Maslinolov/Wideband_Oxygen_Sensor/Readme.txt

В качестве инидкатора используется проект Nixie_Thermometer
