Maslinolov/Wideband_Oxygen_Sensor/Australian DIY Wide Band Information_files/riro.gif

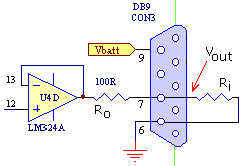
Australian DIY Wide Band Information_files/riro.gif
