Maslinolov/Wideband_Oxygen_Sensor/Australian DIY Wide Band Information_files/voutoff.gif

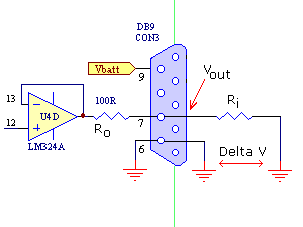
Australian DIY Wide Band Information_files/voutoff.gif
