Maslinolov/Wideband_Oxygen_Sensor/Australian DIY Wide Band Information_files/wblambda.gif

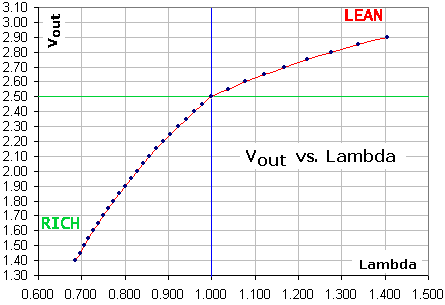
Australian DIY Wide Band Information_files/wblambda.gif
