Maslinolov/Wideband_Oxygen_Sensor/diy-wb_a.gif

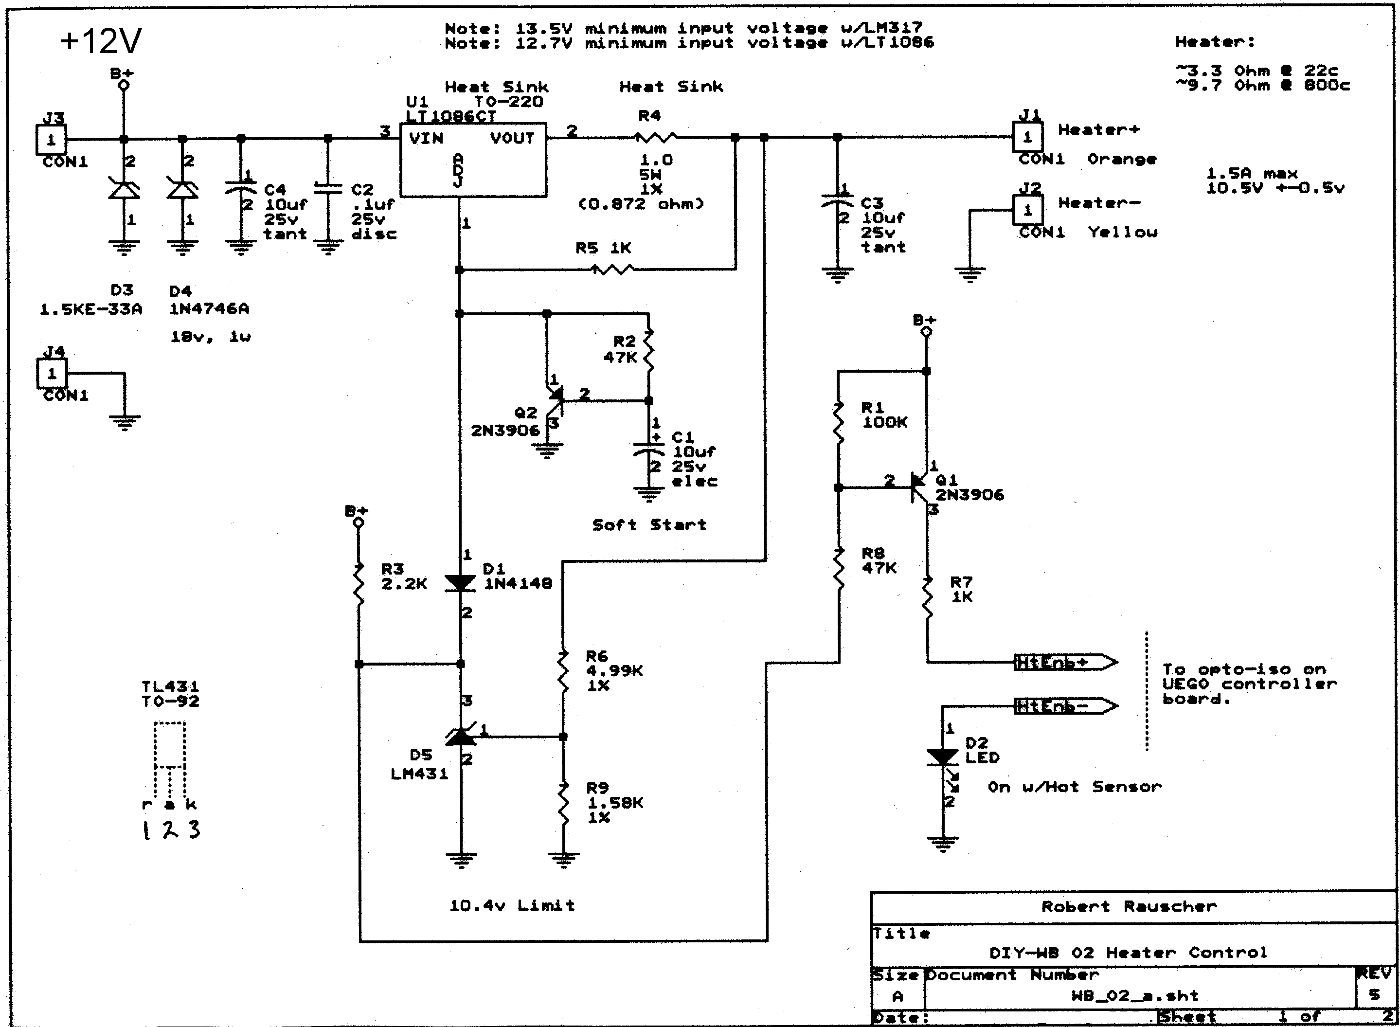
diy-wb_a.gif
