Maslinolov/Wideband_Oxygen_Sensor/diywb_b.gif

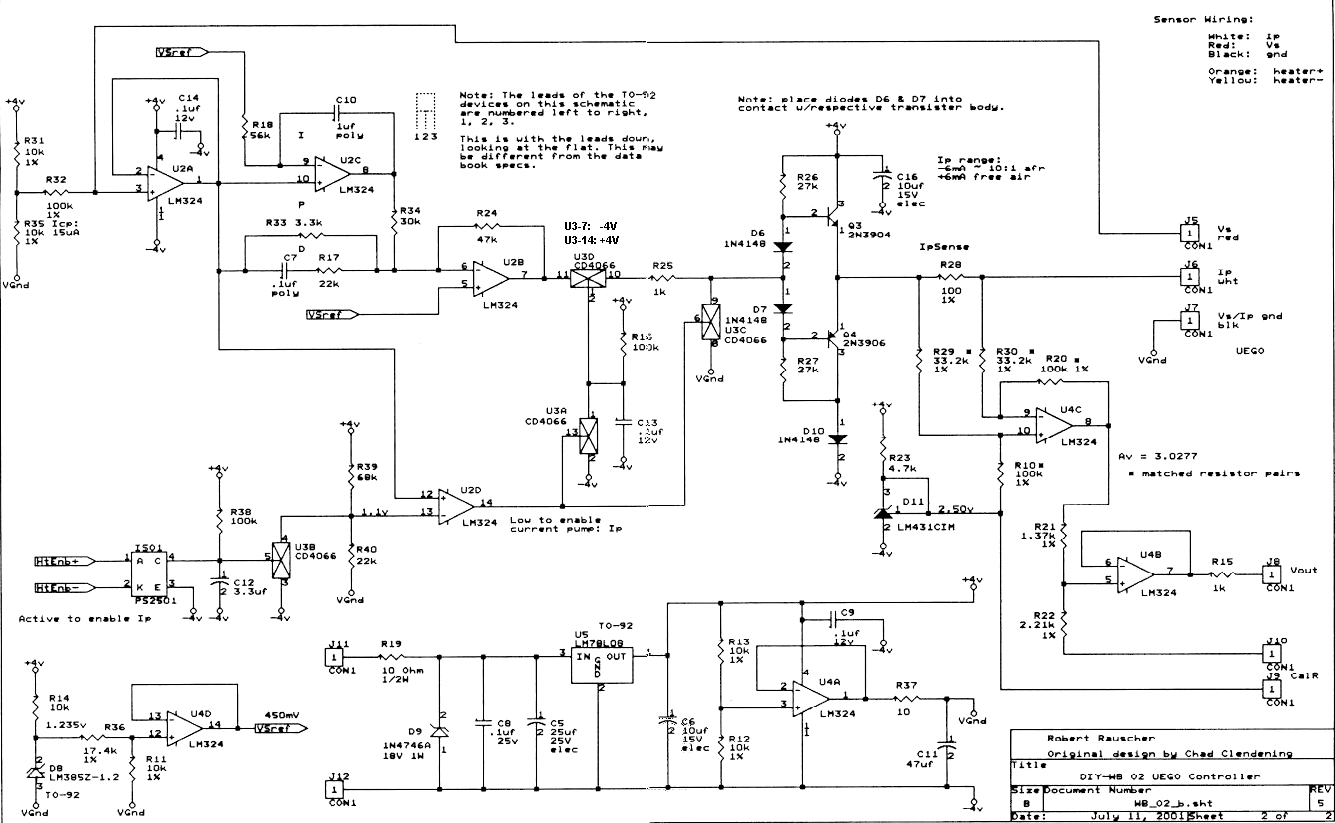
diywb_b.gif
