Maslinolov/Wideband_Oxygen_Sensor/gdriver1.jpg

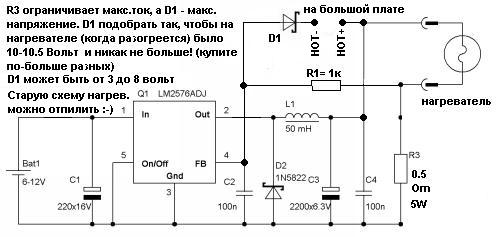
gdriver1.jpg
