Maslinolov/Wideband_Oxygen_Sensor/pcb_v0.1/Project Outputs for WBO_Sensor_v0.1/WBO_Sensor_v0.1.xlsx

Comment | Description | Designator | Footprint | LibRef | Quantity
0.1u |  | C1, C2, C5, C7, C10, C13, C15 | CR2012-0805 | C0805-0.1u-X7R | 7
1u |  | C3 | CR2012-0805 | C0805-1u-X7R | 1
C3.3uFx16V |  | C4 | C6.3x11 | C10uFx16V | 1
C10uFx16V |  | C6, C9 | C6.3x11 | C10uFx16V | 2
C47uFx25V |  | C8, C11 | C6.3x11 | C47uFx25V | 2
220uFx25V | SY025M0220A3F-0811 | C12 | C8x11.5 | C220uFx25V YAGEO SY | 1
470uFx25V |  | C14 | C10x16 | C470uFx25V KF | 1
L78L08ACZ' |  | DA1 | to-92 | L78L08ACZ' | 1
LM2576HVT-ADJ | <B>LM 2576 Adj</B><br> SIMPLE SWITCHER 3-A Step-Down Voltage Regulator | DA2 | TO220-5 | LM2576ADJ | 1
LM324 | General Purpose Amplifier 4 Circuit 14-SOIC | DA2, DA4 | SOIC127P600X175-14N | LM324 | 2
CD4066BM | Bilateral, FET Switches 1 x 1:1 14-SOIC | DA3 | SOIC127P600X175-14N | CD4066BM | 1
PS2501-1 |  | DA5 | DIP4-Gull Wing | PS2501-1 | 1
GREEN |  | HL1 | CR3216-1206-LED | LED_GREEN_1206 | 1
50uH |  | L1 | RCH114 | RCH114NP-221KB | 1
10k 1% |  | R1, R2, R25, R27, R29, R30 | CR2012-0805 | R0805-10k-1% | 6
100k 1% |  | R3, R20, R21 | CR2012-0805 | R0805-100k-5% | 3
56k |  | R4 | CR2012-0805 | R0805-51k-5% | 1
3.3k |  | R5 | CR2012-0805 | R0805-3k3-5% | 1
22k |  | R6, R12 | CR2012-0805 | R0805-22k-5% | 2
30k |  | R7 | CR2012-0805 | R0805-30k-5% | 1
47k |  | R8 | CR2012-0805 | R0805-47k-5% | 1
100k |  | R9, R10 | CR2012-0805 | R0805-100k-5% | 2
60k |  | R11 | CR2012-0805 | R0805-47k-5% | 1
1k |  | R13, R24, R32 | CR2012-0805 | R0805-1k-5% | 3
27k |  | R14, R15 | CR2012-0805 | R0805-22k-5% | 2
4.7k |  | R16 | CR2012-0805 | R0805-4k7-5% | 1
100 1% |  | R17 | CR3216-1206 | R1206-100-5% | 1
33k 1% |  | R18, R19 | CR2012-0805 | R0805-33k-5% | 2
10k |  | R22, R23 | 3296W | 3296W-1-103 | 2
20k |  | R26 | 3296W | 3296W-1-103 | 1
10 |  | R28, R31 | R-1W | R-1W-10R | 2
5 |  | R33 | R-1W | R-1W-5R1 | 1
1N4148 | Diode Standard 100V 200mA Through Hole DO-35 | VD1, VD2, VD3 | DO35-10 | 1N4148 | 3
TL-431LP |  | VD4 | TO-92 | TL-431LP | 1
LM385Z-2.5/NOPB | Shunt Voltage Reference IC Â±3% TO-92-3 | VD5 | DIO_LM385Z-2.5/NOPB | LM385Z-2.5/NOPB | 1
18V1W |  | VD6 | DO-41 | 1N4746A | 1
1N5822 | Diode Schottky 40V 3A Through Hole | VD7 | DIOAD2120W130L950D530P | 1N5822 | 1
8V |  | VD8 | SOD-80 | BZV55-C3V0 | 1
2N3904 | TO-92 | VT1 | TO-92 | 2N3904 | 1
2N3906 | TRANS PNP 40V 0.2A TO92 | VT2 | TO-92 | 2N3906 | 1
PLS-6 |  | XP1 | PLS-6 | PLS-6 | 1
PLS-2 |  | XP2, XP3, XP4 | PLS-2 | PLS-2 | 3
62 ом 1206
22 ком 0805
200 ком 0805
0.33 мкф 0805
bzv55 от 3 до 8 вольт
L1 44315
irfz44
220 ом 1 вт
