Maslinolov/Wideband_Oxygen_Sensor/STL/Body.stl

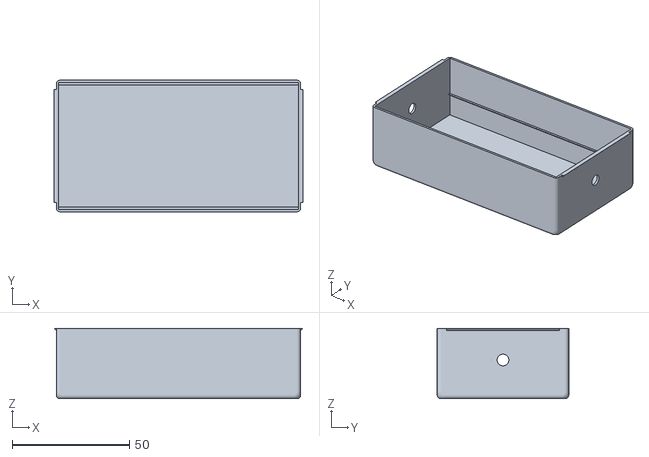
[picture p21: CAD file, 2020-10-11]
STL/Body.stl
106.0 x 56.0 x 30.0
