Maslinolov/Wideband_Oxygen_Sensor/STL/Head.stl

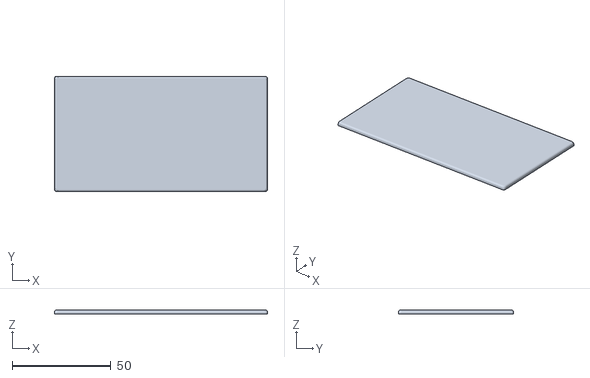
[picture p22: CAD file, 2020-10-11]
STL/Head.stl
108.0 x 58.5 x 2.00
