Maslinolov/Wideband_Oxygen_Sensor/(list of files, drawings)

Other design files:
pcb_v0.1/Heater.SchDoc
pcb_v0.1/Main.SchDoc
pcb_v0.1/PCB.PcbDoc
pcb_v0.1/Power.SchDoc
pcb_v0.1/WBO_Sensor_v0.1.PrjPcb
