Maslinolov/Wideband_Oxygen_Sensor/pcb_v0.1/Testing PCB.docx

Проверка контроллера для NTK датчика

Проверка по шагам:
Для проверки нужен цифровой мультиметр.
1. Не подключать +12 В к схеме управления нагревателем.
2. Не подключать датчик.
3. Убедиться, что R17=100 Ом (99...101).
4. Подать питание только на плату контроллера.
5. Измерить напряжение на оптопаре между ногами 1 и 2. Должно быть 0 вольт.
- Если это не так, то скорее всего подано еще +12 вольт на схему управления
нагревателем или же он неисправен (небольшой каламбур - буржуи писали).
Соединить минусовой провод вольтметра на землю контроллера.
6. Напряжение на микросхеме DA1 нога 1 должно быть 8 вольт (7,6 В ... 8,4 В).
- Если нет: проверь R28, VD6, C7 и C8. Возможно DA1 дохлая.
7. Напряжение на микросхеме DA4 нога 1 должно быть 4 вольт (3,8 В ... 4,2 В).
- Если нет: проверь DA4, C9, R29, R30.
8. Напряжение в точке Vs/Ip должно быть таким же как и в пункте 7.
- Если нет: проверь R31 и С11.
9. Напряжение на VD4 (1 или 3 нога) должно быть 2,5В (2,45 В ... 2,55 В).
- Если нет: проверь VD4 и R16.
10. Напряжение на DA4 нога 8 должно быть 2,5В (2,45 В ... 2,55 В).
Напряжения на ногах 9 и 10 микрухи DA4 должны быть близки друг к другу и около 3,6В.
- Если нет: проверь R18, R19, R21 и R20.
11. Напряжение на DA4 нога 7 должно быть 2,5В (2,45 В ... 2,55 В).
- Если нет: проверить джампер CalR, R20, R24, R22 и R23.
12. Напряжение на DA3 нога 5 должно быть 7,9 ... 8,0 Вольт.
- Если нет: проверить DA5 (оптопара), R10 и C4.
13. Напряжение на DA3 нога 4 должно быть ~0 вольт.
- Если нет: проверить DA5 (оптопара), DA3, R10 и C4.
Теперь подключить минусовой вывод вольтметра к точке Vs/Ip
14. Напряжение на DA4 нога 14 должно быть 0.45В (0.441 В ... 0.459 В).
- Если нет: на VD5 нога 2 должно быть 1.235 В (1.21 В ... 1.26 В).
- Если и это не так, то проверяем R27, R25, R26, VD5.
15. Напряжение на DA6 нога 14 должно быть 2,75В.
Столько же на DA3 нога 6 и нога 13.
16. Напряжение на DA3 нога 12 должно быть -4 В.
17. Напряжение в точке Vs должно быть 2 В (1.9 В ... 2.1 В).
- Если нет: проверь R1, R2 и R3.
18. Напряжение на DA6 нога 1 должно быть 2 В (1.9 В ... 2.1 В).
- Если нет: проверь DA6.
19. Напряжение на DA6 нога 8 должно быть 2,7 В.
- Если нет: проверь R4, C3, R7 и R5.
20. Напряжение на DA6 нога 5 и нога 9 должно быть 0.45 В (0.441 ... 0.459 В).
- Если нет: проверь R4.
21. Напряжение на DA6 нога 7 должно быть -3,4В.
- Если нет: проверь DA6, R8, R5, R7, C2 и R6.
22. Напряжение на DA3 нога 9 должно быть 0 вольт.
- Если нет: проверь R13, DA3, VD1 и VD2.
23. Напряжение на VT2 нога 3 (коллектор) должно быть -3,5В.
- Если нет: проверь VD3, R15 и VT2.
24. Напряжение в точке Ip должно быть около 0 Вольт (+/-0.1В)
- Если нет: проверь VD1, VD2, R14, R15, VT1, VT2 и R17.
Имитируем сигнал разрешения работы контроллеру со схемы управления нагревателем замкнув 3ю и 4ю ноги оптопары (или конденсатор С4).
Теперь подключить минус вольтметра обратно на землю контроллера.
25. Напряжение на DA3 нога 5 должно быть меньше 0.1 Вольта.
- Если нет: проверь DA5, C4 и R10.
Теперь еще раз подключить минусовой вывод вольтметра к точке Vs/Ip
26. Напряжение на DA6 нога 13 должно быть 0.9 ... 1.2 Вольта.
- Если нет: проверь R11 и R12.
Отключить питание и подключить (подпаять) выключатель между DA4 нога 14 и DA6 нога 3. Замыкание выключателя приводит к началу медленного изменения напряжений, а размыкание - к быстрому сбросу до первоначальных значений.
27. Разомкнуть выключатель.
28. Дать +12 Вольт на контроллер.
29. Замкнуть выключатель.
30. Напряжение на DA6 нога 1 должно быть 0.45 В (0.441 ... 0.459 В).
31. Напряжение на DA3 нога 1 должно быть около 4 Вольт.
- Если нет: проверь R9, С5 и DA3.
32. Разомкнуть выключатель.
33. Напряжение на DA6 нога 8 должно быть около 2,7 Вольт.
34. Продолжая замерять напряжение на DA6 нога 8 замкнуть выключатель. Напряжение должно медленно падать. Где-то через 2 минуты должно достичь -3,4 Вольта.
- Если нет: проверь C3, R4, R7 и DA6.
35. Разомкнуть выключатель.
36. Напряжение в точке Ip должно быть около 0 Вольт.
Замкнуть выключатель. Напряжение должно упасть до около -2,7 Вольта и медленно расти до 2,4 Вольта.
Следующий тест проверяет ток ячейки и схему выходного напряжения. Нужен резистор 220 Ом 1 Ватт.
37. Разомкнуть выключатель.
38. Установить джампер на разъем CalR.
39. Подключить вышеупомянутый резистор между Ip и Ip/Vs. Подключить минус вольтметра к земле контроллера.
40. На выходе контроллера (точка Vout) должно быть 2,5 Вольта.
41. Замкнуть выключатель.
42. Напряжение резко упадет. После некоторой паузы будет медленно расти.
Пройдет около 1 минуты и 15 секунд прежде чем напряжение достигнет максимума.
Для резистора 220 Ом начальное напряжение около 1,5 Вольта, а конечное около 3,7 Вольта.
Отключить вольтметр. Снять джампер с разъема CalR. Отпаять выключатель. Разомкнуть контакты 3 и 4 оптопары DA5.
Обязательно поставить по цепи +12 вольт предохранитель (на 3 ампера пойдет).

Теперь контроллер для датчика NTK готов к использованию (осталось только убедиться, что схема управления нагревателем работает).
Работоспособность проверяется без подключенного датчика. После 5-6 секунд после включения светодиод должен загореться.
С датчиком он загорится через более длительное время (до 1 минуты).


Чтобы переделать контроллер под LSU необходимо:
1. Заменить резистор R17 на 62 Ом (желательно 61.9).
2. Заменить резисторы R20 и R21 на 200k (желательно очень близкие по значению).
3. То же и для резисторов R18 и R19. Меняем на 22k.
4. Я еще поменял конденсатор С3 с 1мкф на 0.33мкф.
Теперь датчик LSU подключается к точкам Ip, Ip/Vs, Vs, RCal (не путать с джампер CalR!!!), HT+, HT-.
Самое главное - проверка. После подключения датчика и питания +12 В (с компа не подойдет - маловато) и когда загорится светодиод напряжение на выходе контроллера (на чистом воздухе без паров бензина, газа и т.п.) должно быть около 4 Вольт (3,98 ... 4,02).
4 вольта будет при условии, что на 10й ноге U4 2,5 Вольта. Главное не 4 Вольта (может быть и 4,07 В/2,57 В), а разница между ними в 1,5 Вольта.
